raymondh2/NevermoreMaxController/(commit log)

2021-06-24 Move libs
    [NevermoreController-B_Cu.gbr, NevermoreController-B_Mask.gbr, NevermoreController-B_Paste.gbr, NevermoreController-B_SilkS.gbr, NevermoreController-Edge_Cuts.gbr, NevermoreController-F_Cu.gbr, NevermoreController-F_Mask.gbr, NevermoreController-F_Paste.gbr]
2021-06-26 Fix USB pinout
    [NevermoreController-B_Cu.gbr, NevermoreController-B_Mask.gbr, NevermoreController-B_Paste.gbr, NevermoreController-B_SilkS.gbr, NevermoreController-Edge_Cuts.gbr, NevermoreController-F_Cu.gbr, NevermoreController-F_Mask.gbr, NevermoreController-F_Paste.gbr]
2021-06-26 Remove blind vias
    [NevermoreController.kicad_pcb]
2023-03-07 in progress
    [NevermoreController.kicad_pcb, NevermoreController.kicad_sch]
